Teknosofen/ParallelMixer/documentation/presentation/Ventilator_Control_Architecture_Claude_S3_outside_VSC.pptx

Ventilator Control Architecture

Three-Layer Control System for Medical Ventilators

Åke

## Slide 2

System Overview

Layer 3: High-Level Controller (HLC)

8-state ventilation mode control

Layer 2: Low-Level Controller (LLC)

Breathing phase control (insufflation/exsufflation)

Layer 1: PID Controllers

Actuator control (O2, Air, Exp Valve, Blower)

Control Philosophy: Indirect control through setpoint manipulation

## Slide 3

Layer 1: PID Controllers

O2 Flow

Controls oxygen flow rate

Air Flow

Controls air flow rate

Exp Valve

Controls expiratory pressure

Blower

Controls blower flow rate

- Characteristics:
Independent operation
Sensor scaling and linearization
Receives setpoints from LLC
Fast, stable control loops

## Slide 4

Layer 2: Low-Level Controller

Insufflation State

- Delivers gas to patient
- Controls O2 and Air flow
- Maintains insp pressure

Exsufflation State

- Releases pressure
- Controls exp valve
- Maintains PEEP

State Transitions:

- Patient effort detection (flow/pressure triggers)
Setpoint changes from HLC
Pressure limiting for safety

LLC → HLC Communication:

State changes, measured tidal volume, pressure limit events

## Slide 5

LLC Parameters (Set by HLC)

FiO2

Fraction of inspired oxygen (0.21-1.0)

Insufflation Pressure

Target pressure during inspiration

Pressure Limit

Maximum allowed airway pressure

Exsufflation Pressure (PEEP)

Target pressure during expiration

Insufflation Flow

Target flow rate during inspiration

Bias Flow

Continuous flow during expiration

Max Inspiratory Flow

Maximum allowed inspiratory flow

Flow Trigger Threshold

Flow change to detect patient effort

Pressure Trigger Threshold

Pressure change to detect patient effort

HLC controls LLC behavior by manipulating these setpoints

## Slide 6

HLC Parameters

Timing Parameters:

- Respiratory Rate (RR) - breaths per minute
I:E Ratio - inspiration to expiration time ratio
Inspiratory Pause Fraction - plateau time as fraction of cycle
State Durations - time for each of the 8 states (can be zero)

Pressure Parameters:

- Inspiratory Pressure - baseline during inspiration
PEEP - baseline during expiration
Insp Support Pressure - boost when patient triggers in insp support
Exp Support Pressure - boost when patient triggers in exp support
Pressure Limit - maximum safety limit

Flow & Volume Parameters:

- Tidal Volume (Vt) - target volume per breath
Max Inspiratory Flow - flow rate limit
Bias Flow - continuous background flow

## Slide 7

Layer 3: High-Level Controller

8-State Sequential State Machine

Inspiration Sequence

1. Non-triggerable

Fixed mandatory breath

Expiration Sequence

5. Non-triggerable

Fixed expiration phase

2. Support

Patient can trigger pressure support

6. Support

Patient can trigger support

3. Synch

Patient-synchronized transition

7. Synch

Patient-synchronized transition

4. Pause

Inspiratory plateau

8. Pause

Expiratory pause

## Slide 8

Tidal Volume Control

Initial Flow Calculation

Insufflation Flow = Vt / Active Inspiration Time

Breath-to-Breath Adaptive Control:

1. Measure actual delivered tidal volume (Vt_measured)
2. Calculate error: ΔVt = Vt_target - Vt_measured
3. Gradually adjust flow setpoint for next breath:
• If Vt_measured < Vt_target → increase flow
• If Vt_measured > Vt_target → decrease flow

Pressure-Limited Volume Control

When pressure reaches limit → flow reduced → volume sacrificed for safety

## Slide 9

Pressure Support Mechanism

Inspiration Support State

When patient trigger detected:

LLC Insufflation Pressure = Insp Pressure + Insp Support Pressure

Expiration Support State

When patient trigger detected:

LLC Insufflation Pressure = PEEP + Exp Support Pressure

Benefits:

- Rewards patient inspiratory effort
Reduces work of breathing
Common in PSV (Pressure Support Ventilation) modes

## Slide 10

Inspiratory Pause Implementation

Purpose:

- Plateau pressure measurement
Assessment of static lung compliance
Equilibration of airway and alveolar pressures

The Mechanism: Elegant Setpoint Manipulation

Bias Flow → 0
PEEP Setpoint → 100 cmH2O

Result: System is mechanically locked

- No gas flows in (zero bias flow)
No gas escapes (exp valve closed, actual pressure << 100 cmH2O)
Volume held constant without special pause mode logic

## Slide 11

Design Advantages

Modularity

Clear separation of responsibilities across layers

No Direct Commands

Simplifies interfaces and reduces coupling

Extensibility

New ventilation modes via timing/parameter configuration

Patient Synchronization

Built into state machine architecture

Safety

Multiple protection layers (LLC pressure limiting, HLC limits)

Adaptability

Breath-to-breath learning handles patient variability

## Slide 12

Ventilator Control Architecture

Questions?
