Teknosofen/ParallelMixer/documentation/Pinout Honeywell ABP2 & Sensirion SFM3505.docx

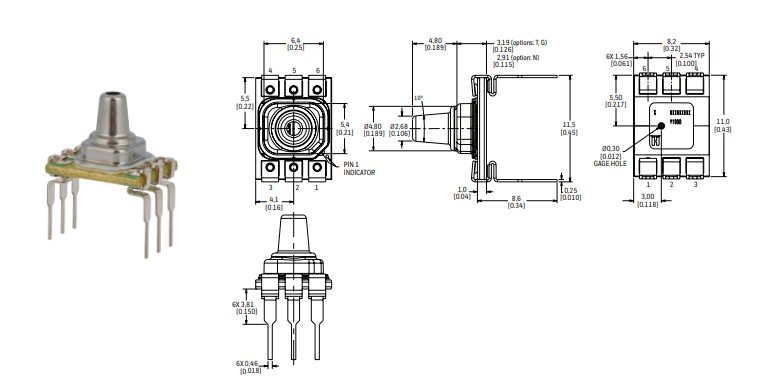
[picture p6: figure]
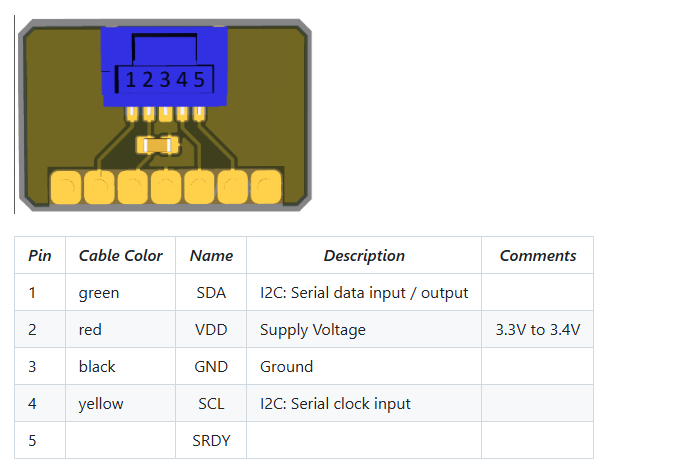
[picture p7: figure]

Sensirion SFM3505
