Teknosofen/ParallelMixer/documentation/presentation/LundaLogger_2026-02-27 -3rd-try.pptx

## LundaLoggern

En datalogger

- Åke 2026-02-27

## LundaLoggern


Presentation name

## LundaLoggern

## Slide 4
