Teknosofen/ParallelMixer/documentation/presentation/Old_stuff/VentilatorArchitecture_S3-variant.pptx

## Three-Layer Ventilator Control Architecture

A modular, setpoint-driven approach
to medical ventilator control

- v1.1 · 2026-02-01

## Architecture Overview

- Three-layer hierarchy
  - Layer 1 — Actuator Layer: fast PID loops for individual valves and blower
  - Layer 2 — LLC: breathing phase state machine (insufflation / exsufflation)
  - Layer 3 — HLC: ventilation mode logic, 8-state cycle
- Core philosophy: indirect control through setpoint manipulation
  - Higher layers never issue explicit commands — they change setpoints only
  - Lower layers react automatically when trigger conditions are met
- Update rates
  - Layer 1: 100–1000 Hz Layer 2: ~100 Hz Layer 3: 10–50 Hz

## Layer 1: Actuator Controllers

- Four independent PID controllers
  - O2 Flow Controller — controls O2 valve
  - Air Flow Controller — controls air valve, handles linearisation tables
  - Expiratory Valve Controller — controls exp pressure / valve position
  - Blower Flow Controller — controls blower flow rate
- Key characteristics
  - Each controller operates independently at the highest loop rate
  - Handles sensor & actuator non-linearities via piecewise lookup tables
  - No knowledge of breathing phases or ventilation modes
  - All setpoints received from LLC — outputs go directly to hardware drivers

## Interface: LLC → Layer 1

- LLC writes setpoints; Layer 1 controllers read them each cycle
- During Insufflation
  - Air flow setpoint [slm] — to Air Flow Controller
  - O2 flow setpoint [slm] — to O2 Flow Controller (FiO2 determines split)
  - Exp valve pressure [mbar] — held at high value to keep exp valve closed
- During Exsufflation
  - Air & O2 flow setpoints → 0 (or Bias Flow) — valves nearly closed
  - Exp valve pressure setpoint = PEEP — exp valve opens to target pressure
- Pressure limiting (active at all times)
  - Layer 1 flow controllers reduce output when Paw approaches Pressure Limit
  - LLC does not need to poll for this — Layer 1 handles it autonomously

## Layer 2: LLC — Breathing Phase Control

- Insufflation (Inspiration)
  - Delivers pressure / flow to patient via O2 and Air controllers
  - Maintains target inspiratory pressure
  - Pressure limiting: reduces flow when Paw approaches pressure limit
- Exsufflation (Expiration)
  - Controls expiratory valve to manage pressure release
  - Maintains PEEP (positive end-expiratory pressure)
- State transitions triggered by
  - Patient effort — flow or pressure crosses trigger threshold
  - Setpoint changes from HLC — may instantly fulfil trigger criteria

## LLC: Parameters Set by HLC

- Pressure: Insufflation Pressure, Pressure Limit, PEEP
- Flow: Insufflation Flow, Bias Flow, Max Inspiratory Flow
- Oxygen: FiO2 (0.21 – 1.0)
- Triggers: Flow Trigger Threshold, Pressure Trigger Threshold

## Interface: HLC ↔ LLC

- HLC → LLC (setpoints, updated every HLC cycle)
  - Insufflation Pressure [cmH2O / mbar]
  - Pressure Limit [cmH2O / mbar] — hard safety ceiling
  - PEEP [cmH2O / mbar] — exsufflation target pressure
  - Insufflation Flow [slm] — adapted breath-to-breath for Vt
  - Bias Flow [slm] — set to 0 during Insp Pause
  - FiO2 [0.21 – 1.0]
  - Flow Trigger Threshold [slm] — HLC adjusts per state
  - Pressure Trigger Threshold [cmH2O] — HLC adjusts per state
- LLC → HLC (events, asynchronous)
  - State change event — fired on insufflation ↔ exsufflation transition
  - Tidal volume report — integrated flow delivered during inspiration [ml]
  - Pressure limit event — fired when Layer 1 pressure limiting was active

## Layer 3: HLC — 8-State Breathing Cycle

- Inspiration sequence
  - 1. Non-triggerable — mandatory breath, patient triggers ignored
  - 2. Support — patient trigger adds Insp Support Pressure
  - 3. Insp Synch — LLC exsufflation event advances HLC (default: 0 s)
  - 4. Insp Pause — holds volume; Bias Flow = 0, PEEP = 100 cmH2O
- Expiration sequence
  - 5. Non-triggerable — minimum expiration time, triggers ignored
  - 6. Support — patient trigger adds Exp Support Pressure
  - 7. Exp Synch — LLC insufflation event advances HLC (default: 0 s)
  - 8. Exp Pause — holds expiratory state for measurement

## HLC: State Transitions & Timing

- States advance on
  - Time elapsed — each state has a configured duration
  - Zero-duration skip — states with time = 0 are immediately bypassed
  - Patient sync — LLC state-change events trigger HLC advance in Synch states
- Timing parameters
  - Respiratory Rate (RR) Cycle time = 60 / RR seconds
  - I:E Ratio Splits cycle into inspiration / expiration time
  - Insp Pause Fraction Pause time = fraction x (60 / RR)
  - Active Inspiration Time = Non-trig + Support + Synch (pause excluded)
- Active Inspiration Time drives the tidal volume flow calculation

## Tidal Volume Control

- Initial flow calculation
  - Insufflation Flow = Vt_target / Active Inspiration Time
  - Pause time excluded — no gas flows during plateau hold
- Breath-to-breath adaptive control (at each insp → exp transition)
  - Measure Vt_delivered (integrated flow over inspiration from LLC event)
  - Error: dVt = Vt_target - Vt_delivered
  - Gradually adjust Insufflation Flow setpoint for next breath
  - Compensates for changing patient compliance and resistance
- Pressure-limited mode
  - LLC pressure limiting reduces flow — LLC reports pressure limit event to HLC
  - HLC attempts to increase flow next breath; if persistent: volume sacrificed
  - Patient safety (pressure) prioritised over volume target

## Pressure Support & Inspiratory Pause

- Inspiration Support (on patient trigger during Insp Support state)
  - HLC sets: Insufflation Pressure = Inspiratory Pressure + Insp Support Pressure
  - Rewards patient effort; foundation of PSV mode
- Expiration Support (on patient trigger during Exp Support state)
  - HLC sets: Insufflation Pressure = PEEP + Exp Support Pressure
- Inspiratory Pause — lock using existing setpoints only
  - HLC sets: Bias Flow = 0 and PEEP = 100 cmH2O
  - PEEP 100 cmH2O forces LLC into exsufflation mode
  - Actual Paw << 100 cmH2O => expiratory valve stays physically closed
  - Result: zero inflow + valve closed = volume held constant
  - No special pause logic needed in LLC

## Indirect Control: State-Dependent Setpoints

- HLC controls LLC exclusively by changing setpoints — never by explicit command
- HLC State Insp Pressure PEEP Bias Flow
  - Insp Non-trig Insp Pressure Normal PEEP Normal
  - Insp Support Insp P + Support * Normal PEEP Normal
  - Insp Synch Insp Pressure Normal PEEP Normal
  - Insp Pause — 100 cmH2O (lock) 0 (lock)
  - Exp Non-trig — PEEP Normal
  - Exp Support PEEP + Support * PEEP Normal
  - Exp Pause — PEEP Normal
- * Only applied when patient trigger is detected in that state
- Setpoint change → LLC trigger criteria may be instantly fulfilled
  - LLC transitions automatically — no command needed from HLC

## Clinical Ventilation Modes

- Volume Control (VC)
  - Insp Non-trig: full mandatory breath
  - Support / Synch: skipped (0 s)
  - Result: time-triggered, volume-cycled
- Assist Control (AC)
  - Insp Non-trig: backup mandatory timing
  - Exp Synch: patient can trigger next breath
  - Full support on every breath

- Pressure Support (PSV)
  - Insp & Exp Synch states active
  - Insp Support: pressure boost on trigger
  - Fully patient-triggered and patient-cycled
- SIMV
  - Mandatory breaths via Non-trig states
  - Supported breaths via Support states
  - Synch states coordinate with patient effort

## Safety & Design Advantages

- Safety layers
  - Pressure limiting always active in Layer 1 — prevents barotrauma
  - Non-trig states guarantee minimum ventilation if patient effort fails
  - Gradual Vt adaptation prevents sudden volume changes
  - Setpoint sanity checks in HLC before values reach LLC
  - Watchdog timers on each HLC state (maximum duration limits)
- Design advantages
  - Modularity — clear single responsibility per layer
  - No direct commands — simpler interface, lower coupling between layers
  - Extensibility — new ventilation modes by timing & parameter config only
  - Patient synchronisation built into the state machine
  - Breath-to-breath learning handles varying compliance and resistance

## Slide 15
