Teknosofen/ParallelMixer/include/CommandParser.hpp

#ifndef COMMAND_PARSER_H
#define COMMAND_PARSER_H

#include <Arduino.h>

// Forward declarations
class ActuatorControl;
class VentilatorController;

// MUX channel definitions
enum MuxChannel : uint8_t {
  MUX_DIRECT    = 0,  // No MUX prefix (direct communication)
  MUX_AIR_VALVE = 1,  // Air valve
  MUX_O2_VALVE  = 2,  // O2 valve
  MUX_EXP_VALVE = 3,  // Expiratory valve
  MUX_BLOWER    = 4,  // Blower (local PWM on GPIO21 + serial to addr 4)
  MUX_AUX       = 5   // Auxiliary serial address (no local hardware)
};

// Get human-readable name for MUX channel
inline const char* getMuxChannelName(uint8_t channel) {
  switch (channel) {
    case MUX_DIRECT:    return "Direct";
    case MUX_AIR_VALVE: return "AirValve";
    case MUX_O2_VALVE:  return "O2Valve";
    case MUX_EXP_VALVE: return "ExpValve";
    case MUX_BLOWER:    return "Blower(PWM)";
    case MUX_AUX:       return "Aux";
    default:            return "Unknown";
  }
}

struct SystemConfig {
  uint32_t delta_t;                    // GUI/Serial output interval in microseconds (T command)
  uint32_t control_interval;           // Control system execution interval in microseconds (X command)
  uint32_t PressSamplTime;             // ABP2 pressure sampling time in microseconds (default: 10000 = 100Hz)
  int16_t quiet_mode;                  // 0=verbose, 1=quiet, 2-8=special modes
  float digital_flow_reference;        // Digital flow reference in L/min
  uint8_t mux_channel;                 // Current MUX channel (0-5), see MuxChannel enum
};

class CommandParser {
public:
  CommandParser();
  
  void begin(unsigned long baud_rate);
  void update();
  bool isCommandReady() const;

  // Access to pending command (for external command handlers)
  const String& getCommandString() const { return _command_str; }
  bool isCommandComplete() const { return _command_complete; }
  void clearCommand() { _command_str = ""; _command_complete = false; }
  
  // Main command processing - pass in system objects
  void processCommands(SystemConfig& config, ActuatorControl& actuator);

  // Ventilator command processing - returns true if command was handled
  bool processVentilatorCommands(VentilatorController& ventilator);
  
  // Command handlers - these return true if command was handled
  typedef bool (*CommandCallback)(char cmd, const String& params, void* context);
  
  void setContext(void* context);
  
  // System configuration commands
  bool handleCommand(String& command);
  
  // Helper methods for common responses
  static void sendOK();
  static void sendOK(const String& value);
  static void sendError();
  static void printHelp();
  static void printSettings(const SystemConfig& config, int controller_mode,
                           float offset, float amplitude, float period_seconds,
                           float valve_signal, uint8_t mux_channel,
                           float sweep_start = 0, float sweep_stop = 0,
                           float sweep_time = 0, bool sweep_log = false);
  
private:
  String _command_str;
  bool _command_complete;
  void* _context;
  
  void serialEvent();
};

#endif
