Teknosofen/ParallelMixer/(commit log)

2025-12-04 feat: added wifi and HTML poresentation of data, added button for WiGFi on/off, added display of data
2025-12-11 FEAT: added two parallel I2C channels for sensor handling, purge and simplified
2026-01-07 remoed second I2C and serial ports, removed old I2C sensors and added boot screeen with version info
2026-01-07 working on I2C, still not functional
2026-01-08 I2C work
2026-01-08 major rework, I2C now works and an initial serial handler for actuator communication is there
    [ActuatorControl.cpp, ActuatorControl.hpp, CommandParser.cpp, CommandParser.hpp, ImageRenderer.cpp, ImageRenderer.hpp, PinConfig.h, SensorReader.cpp]
2026-01-09 more work on the valve controller communication, dat is now at leats received from it
2026-01-12 polished actuator serial comm
2026-01-14 FEAT: Added new low pressure ABPD sensor and improved weg drawing speed and update rates
2026-01-15 update documentation, complile swicth f to handle duplicate I2C addresses
2026-01-19 adjuster I2C clock
2026-01-28 Major rework now using external serial MUX to allow manu controllers, still maintaining backwards compatibility and direct control by selecting the virtusl mUX chalnnel 0
    [ActuatorControl.cpp, ActuatorControl.hpp, CommandParser.cpp, CommandParser.hpp, ImageRenderer.cpp, SerialMuxRouter.cpp, SerialMuxRouter.hpp, main.cpp]
2026-01-29 instrumented and hunting bugs
    [ActuatorControl.cpp, SerialMuxRouter.cpp]
2026-01-29 MUX adressing works as well as legacy non mux motorcontroller communication
2026-01-30 integrated FO2 sensor on Serial2
2026-01-30 Pyroscience O2 sensor now has asynch com at a slow and settable sampling rate
2026-01-31 removed some legacy PWM control logic
2026-02-02 added 2nd I2C bus and ventilator info on LCD and html page
2026-02-23 feat: improved I2C scamn at boot
2026-02-27 feat fixed airwqay press sensor
    [SensorReader.cpp, SensorReader.hpp, main.cpp, main.hpp]
2026-03-04 FEAT: completely reworked valve characterization, now with 2D plane reverse look up
    [CommandParser.cpp, LocalValveController.cpp, LocalValveController.hpp, ValveCharacterizer.cpp, ValveCharacterizer.hpp, main.cpp]
2026-03-04 feat: added PWM blower control under the MUX4 command
2026-05-26 v0.9.8: per-actuator flow source (LOCAL_PI/REMOTE_F), measured FiO2 display, SFM3505 O2-cal feedback, insp valve PI bump (kp 0.10/ki 1.4), MF/TF range to 200 SLM, display/web honor flow source
